olispc/e-ink-planner/(list of files, cad)

Other CAD files:
enclosure/eink_mount.skp
