olispc/e-ink-planner/(commit log)

2026-09-02 Scaffold the panel renderer, sync server deploy, and touch overlay
    The whole software half is buildable before the hardware lands, so it is:
    - panel/ renders Mindwtr next actions to a 800x480 1-bit image and maps taps
    back to rows. Display and touch each have a laptop backend (png / none) and
    a Pi backend (Waveshare UC8179 / evdev), selected by env var, so layout work
    needs no hardware.
    - panel/client.py targets mindwtr-cloud's REST API, with shapes and query
    params read off apps/cloud/src/server.ts rather than guessed.
    - deploy/ has the compose file for mindwtr-cloud, a systemd unit, and the
    device-tree overlay that binds the mainline goodix driver to the GT911.
    - tools/preview.p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
2026-09-02 Lead the panel with today's focus, then fill from next actions
    A next-only panel showed 6 of 56 tasks in arbitrary order, which is a sample
    rather than a plan. The focus view now fetches isFocusedToday first, dedupes,
    and fills the remaining rows from next actions, with a heavy rule marking the
    boundary. Nothing starred degrades to plain next actions rather than a blank
    panel, so the flag is useful without being load-bearing.
    Also: focused rows are marked with a heavier checkbox border, not a filled one
    — the checkbox is the complete-this-task tap target, and a filled box reads as
    already done.
2026-09-04 Add task detail view with checklists, partial refresh, and live updates
    - Tapping a task's title (not its checkbox) opens a detail view: full
    title, meta, a description snippet, and its checklist if it has one.
    Unchecked items sort to the top; done ones stack into a single "N done"
    row with pagination once expanded, rather than each taking a row.
    - Completing a task and toggling a checklist item use the vendored
    Waveshare driver's partial refresh (confirmed against its source and
    demo, not assumed), capped to bound ghosting, with a brief
    checkmark+strikethrough confirmation before a completed row disappears.
    - Poll HEAD /v1/data's ETag (the store file's stat, verified against
    s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
2026-09-04 Split pagination controls into independent forward/back zones
    Both pagers (list view, checklist) previously had one row that only ever
    advanced, wrapping around — reaching an earlier page meant cycling all the
    way through. Now the row splits left/right into independent previous/next
    zones (‹ / ›) around a centered "page X/Y" label, each still wrapping at
    its own end. No Panel changes needed: the existing "page"/"list_page" hit
    kinds already carry a precomputed target page, so this is purely a
    rendering change — two hitboxes per pager row instead of one.
2026-09-04 Add home button, sort by date, and area/project grouping to the list view
    - Tapping the view title is "home": back to list page 1. Sort and grouping
    toggles are deliberately left alone by it — the header controls
    themselves are the only way to change them, so a stray tap on the title
    can't undo a view you set up on purpose.
    - Sort toggle: two arrow buttons (newest/oldest by created date), the
    active direction drawn bigger. A real tri-state — default fetch order,
    newest, oldest — reached with only two buttons by having the
    already-active arrow clear back to default on a second tap, since
    nothing else provides a way back to it.
    - Area and project grouping toggle independent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
2026-09-30 Bring up the real hardware: FTS02 wiring, GT911 on a software I2C bus
    Document the ESP32-FTS02 adapter that actually shipped, move the touch
    overlay to i2c-gpio on GPIO6/13 (INT 19, addr 0x14), fix the service's
    working directory, confirm the digitiser axes need no inversion, and let
    webtest bind to the LAN for testing from a phone.
2026-09-30 Use the driver's fast waveform for the ghosting cleanup
    EPaperDisplay.show() now goes through init_fast() (forced 90°C OTP
    waveform, a shorter flash) unless PANEL_FULL_REFRESH=normal; startup
    keeps the thorough init()+Clear(). Each full refresh logs its duration
    so the two can be compared on the panel.
2026-10-01 Add horizontal swipe as a page-turn gesture
    touch.classify() splits a stroke into tap / swipe / ignored from its start
    and end; Panel.handle_swipe() reuses the current screen's pager hitboxes.
    The evdev reader now queues leftover events instead of dropping them when a
    stroke ends, which made swipes over list rows read as taps.
2026-10-01 Point panel.service at the working copy and set PYTHONPATH for the Waveshare driver
2026-10-04 Refuse to start the e-paper panel unless BUSY reads idle-high
    epd.init() runs the controller's boost converter, which a shifted or
    mirrored 24-pin ribbon delivers to 3.3V pins. A reset is safe on any
    wiring, so check BUSY after one and exit instead of powering up; the
    service retries until the wiring reads right. Also records the remote
    jumper wiring and the failed FPC-extension attempt in the deploy notes.
2026-10-15 Support the replacement panel's FT5426 touch chip and record the panel diagnosis
    The replacement GDEY075T7-T01 ships with a FocalTech FT5426 (0x38, chip id
    0x54) instead of a GT911. Add an overlay for it on the same i2c-gpio bus,
    with touch reset on GPIO26 (Pi pin 37), which this chip needs to leave reset.
    Document the 15th jumper, the flex's opposite contact face, and why plugging
    it straight into P7 mirrors it.
    Also record how the old panel was diagnosed (SPI temperature read-back,
    R12 measurement, Good Display's own demo) and the verified 24-pin extension
    setup that replaces the "don't extend the ribbon" advice.
2026-10-15 Point the example touch device at the stable by-path link
    Loading the touch overlay at boot moved the FT5426 from event4 to event0,
    and event4 became an HDMI device, so a fixed eventN silently reads the
    wrong input.
2026-10-15 Add dark mode and screen lock to the header, drop the sync icon and task count
    Dark mode inverts the finished 1-bit render, so layout and hitboxes are shared
    between modes. Screen lock makes the lock button the only live tap target and
    drops swipes. The header cluster shifts left to make room.
2026-10-17 Add a portrait layout and a header button to rotate between it and landscape
    The UI is drawn upright on a logical canvas, 800x480 or 480x800, described by
    theme.Geometry; render() and render_detail() take their width, header height
    and text edge from it instead of module constants. Landscape output is
    pixel-identical to before. Only the two edges know about rotation, both in
    panel/rotation.py so they cannot disagree: RotatedDisplay turns the finished
    image onto the panel's native frame, and EvdevTouch turns raw touch points
    back before classifying, so a swipe is judged in the frame the user sees.
    Portrait shows about ten list rows (six in landscape) and eleven checklist
    items, and its header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
2026-10-20 Give the screen lock a photo clock and passcode keypad, default to portrait
    The lock screen shows the time and date over a daily background picture from
    PANEL_LOCK_IMAGES (cropped to fill, dithered), and a tap brings up a keypad
    checked against PANEL_PASSCODE, with a doubling cooldown after repeated
    misses. While locked every full refresh uses the thorough waveform, since the
    fast one left the photo pale and ghosted. The panel always starts locked.
    The old header lock becomes the touch lock, the header gets nine wider hit
    slots in portrait, and portrait (270) is now the default orientation.
2026-10-20 Add the SketchUp enclosure mock-ups for the screen head
    eink_mount.rb builds three enclosure options (layered ply, picture frame,
    two plates) with exploded copies; eink_mount.skp is the saved model.
    SketchUp's ~.skp autosave backups are ignored.
    [eink_mount.skp]
2026-10-22 Add view tabs, inbox processing and task editing to the panel
    - Replace the header title with Focus / Inbox / Waiting / Someday tabs,
    drawn as Mindwtr's own icons, with an inbox count badge
    - Fetch every open task in one request and split views locally, so
    switching tab never waits on the network
    - Process inbox tasks on the panel: project or area, contexts and due-date
    pickers (month grid), then Next / Waiting / Someday; each choice is a
    PATCH written immediately, matching Mindwtr's own processor. Sending a
    task on moves to the next one; swiping left skips one
    - Give every other task an Edit screen with the same rows, opened from a
    compact icon block under its title that shows o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
